danja/webplot/docs/media/bot.jpeg

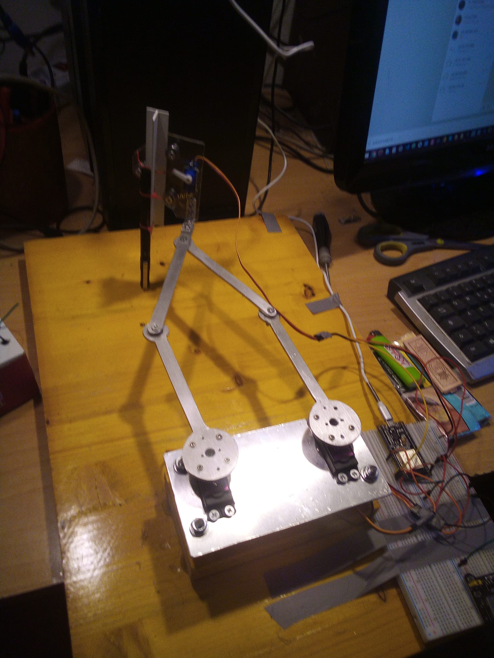
docs/media/bot.jpeg
