danja/webplot/docs/media/precise_10-10-10.png

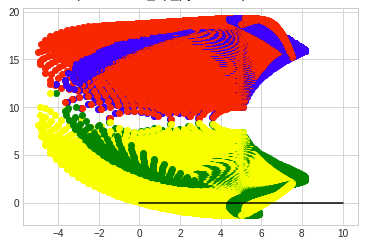
docs/media/precise_10-10-10.png
